ragebits/SE_Datalog/Datasheet Info/LTC3441 implementacion MODE SYNC.png

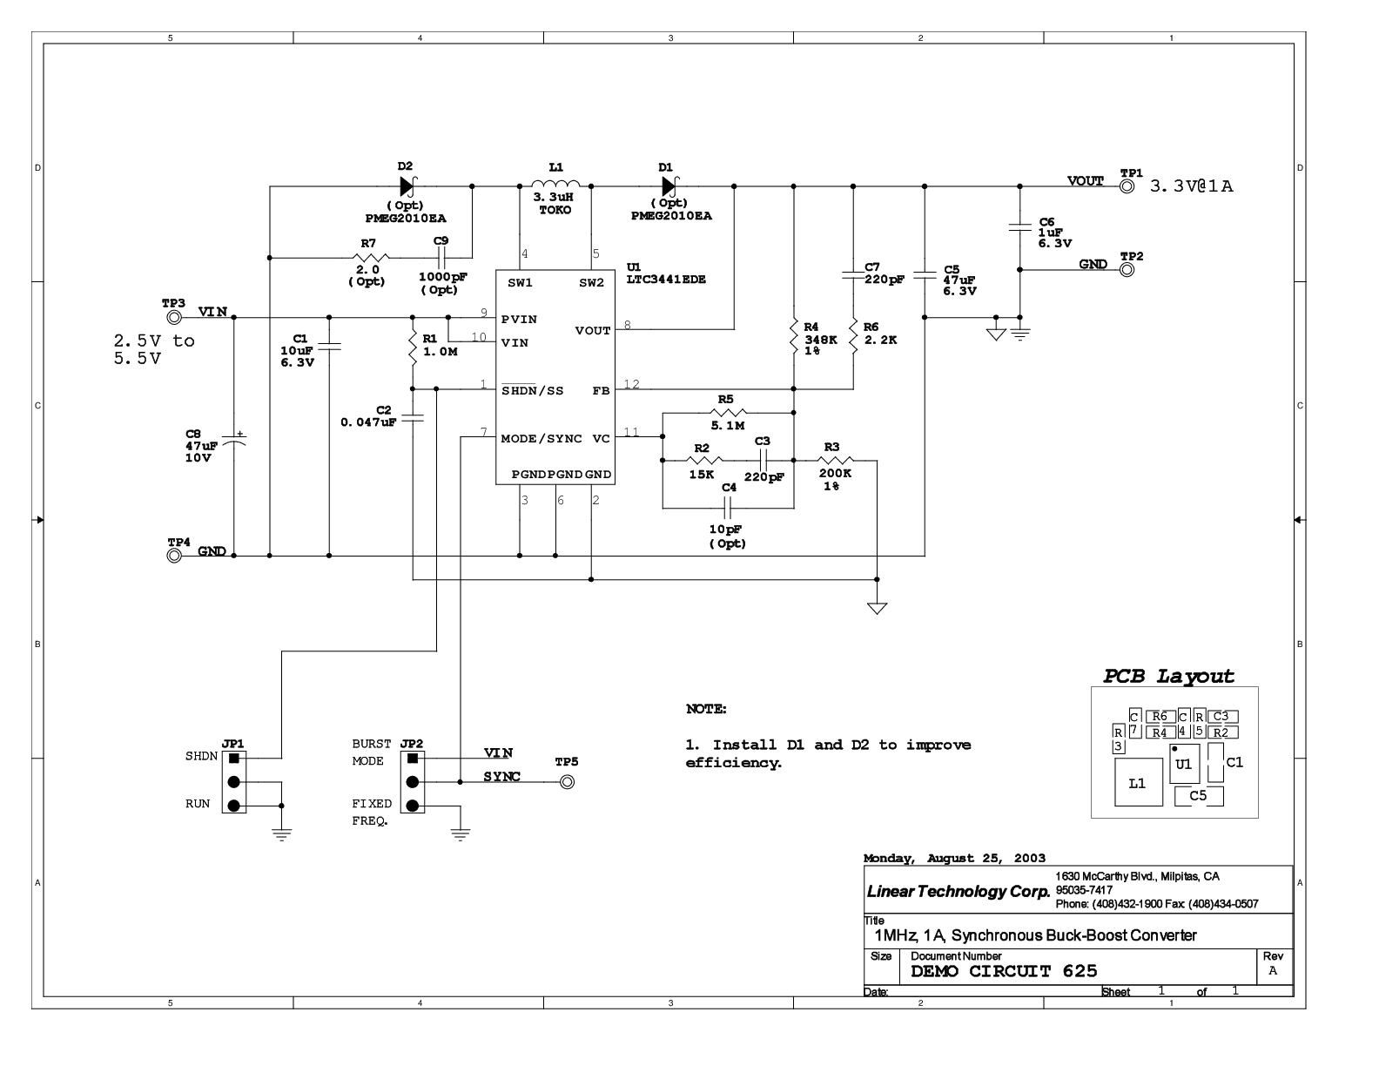
Datasheet Info/LTC3441 implementacion MODE SYNC.png
