ragebits/SE_Datalog/Layout componentes/1264EY-4R7M_P3/1264EY-4R7M_P3.step

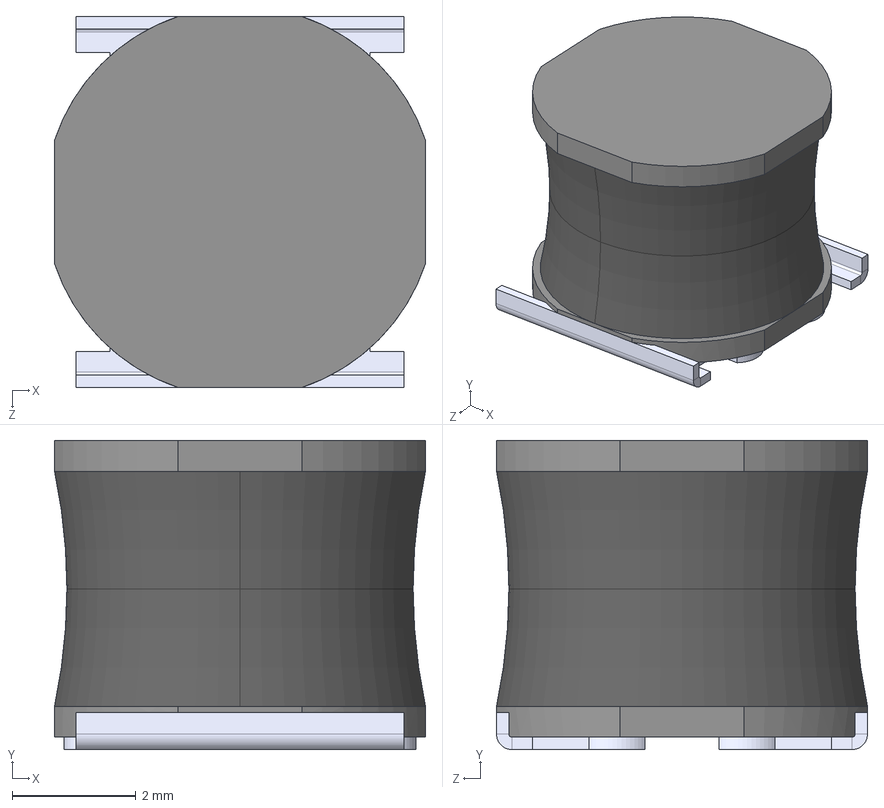
[picture p2: CAD file, 2021-05-06]
Layout componentes/1264EY-4R7M_P3/1264EY-4R7M_P3.step
6.00 x 5.00 x 6.00 mm
