ragebits/SE_Datalog/Layout componentes/B3U-1000P/B3U-1000P.step

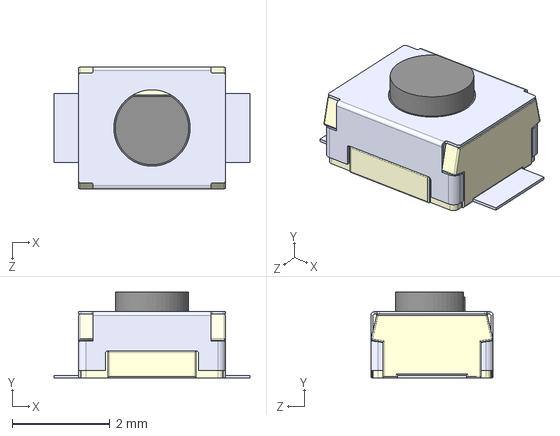
[picture p3: CAD file, 2021-04-28]
Layout componentes/B3U-1000P/B3U-1000P.step
4.00 x 1.75 x 2.50 mm
