ragebits/SE_Datalog/Layout componentes/BMP180-BY-68/bmp180-breakout-board-1.snapshot.2/BMP180 Breakout.step

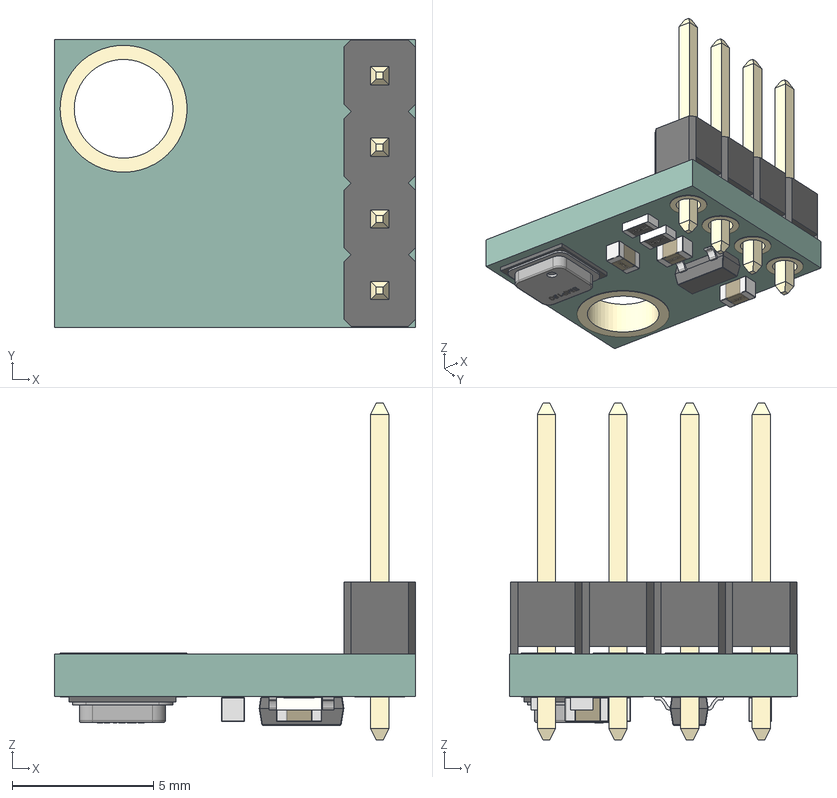
[picture p4: CAD file, 2021-07-25]
Layout componentes/BMP180-BY-68/bmp180-breakout-board-1.snapshot.2/BMP180 Breakout.step
12.8 x 10.2 x 11.9 mm
r-smd-0603 x 2
c-smd-0603 x 3
PinHeader
SOT23SMD v1
BMP180
