ragebits/SE_Datalog/Layout componentes/DM3AT-SF-PEJM5/DM3AT-SF-PEJM5.step

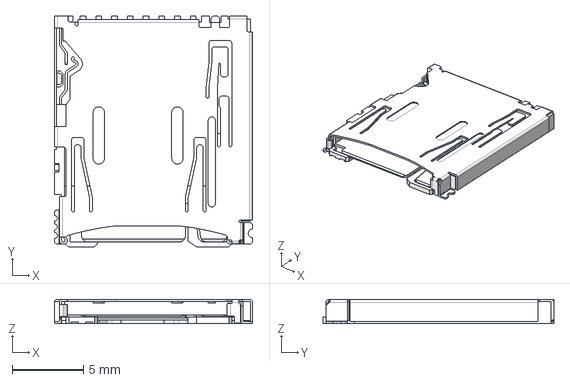
[picture p5: CAD file, 2021-05-06]
Layout componentes/DM3AT-SF-PEJM5/DM3AT-SF-PEJM5.step
13.8 x 16.2 x 1.68 mm
