ragebits/SE_Datalog/Layout componentes/ESP32-WROVER-I/ESP32-WROVER-I.step

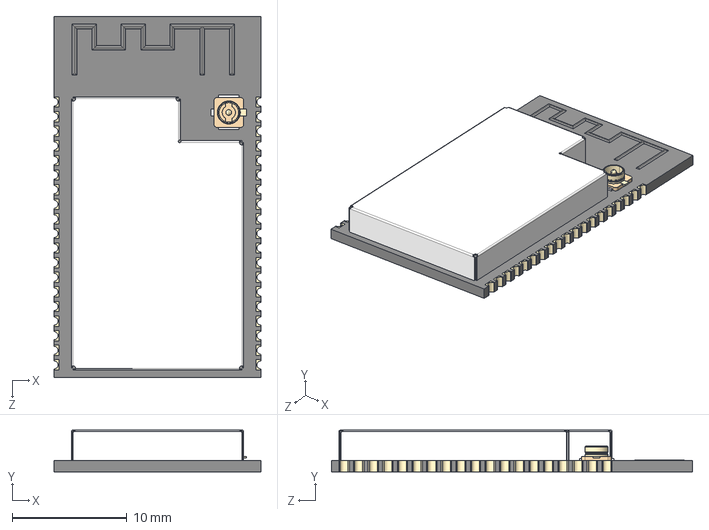
[picture p6: CAD file, 2021-04-28]
Layout componentes/ESP32-WROVER-I/ESP32-WROVER-I.step
18.0 x 3.65 x 31.4 mm
