ragebits/SE_Datalog/Layout componentes/ESP32-WROVER/ESP32-WROVER.step

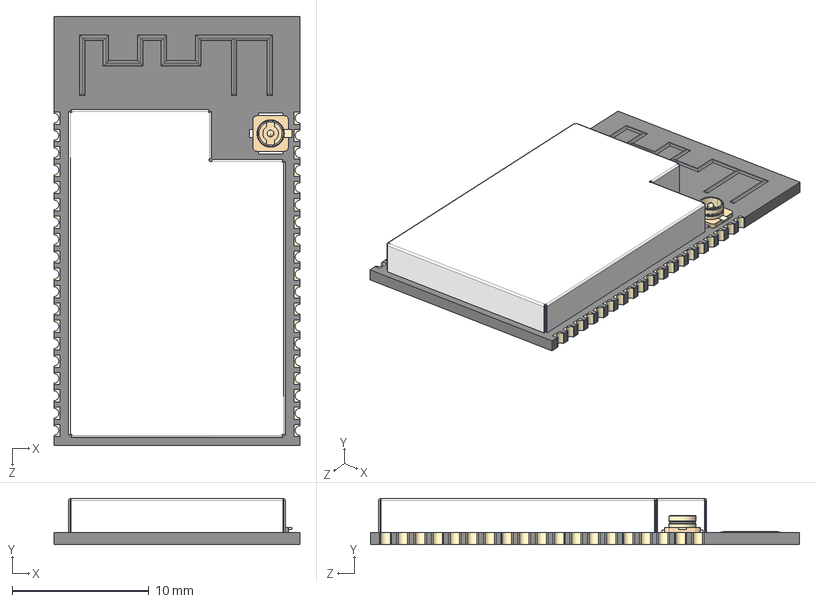
[picture p7: CAD file, 2021-04-28]
Layout componentes/ESP32-WROVER/ESP32-WROVER.step
18.0 x 3.40 x 31.4 mm
ESP-WROOM-02D board
UFL connector
