ragebits/SE_Datalog/Layout componentes/LIB_LTC3441EDE#PBF/LTC3441EDE#PBF/3D/LTC3441EDE#PBF.stp

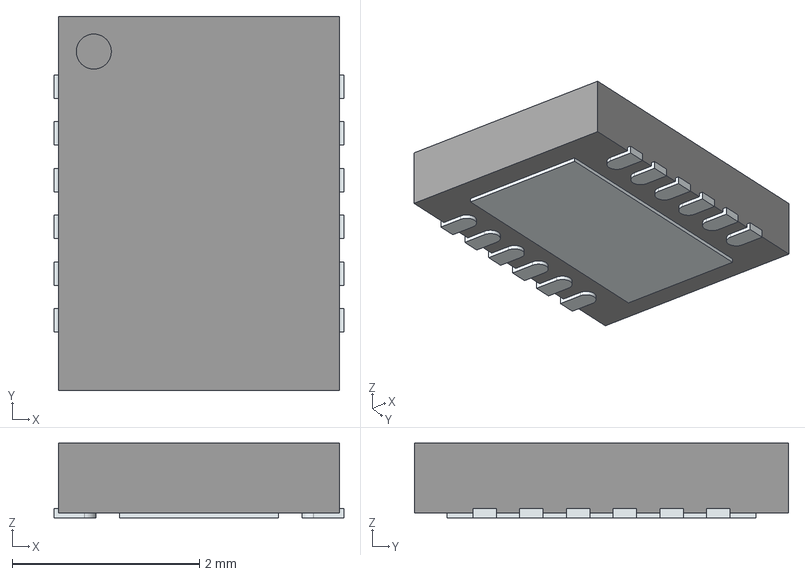
[picture p8: CAD file, 2021-07-20]
Layout componentes/LIB_LTC3441EDE#PBF/LTC3441EDE#PBF/3D/LTC3441EDE#PBF.stp
3.10 x 4.00 x 0.8 mm
ThermalPin
PinsArrayLR
