ragebits/SE_Datalog/Layout componentes/LTC3441EDEPBF/LTC3441EDEPBF.step

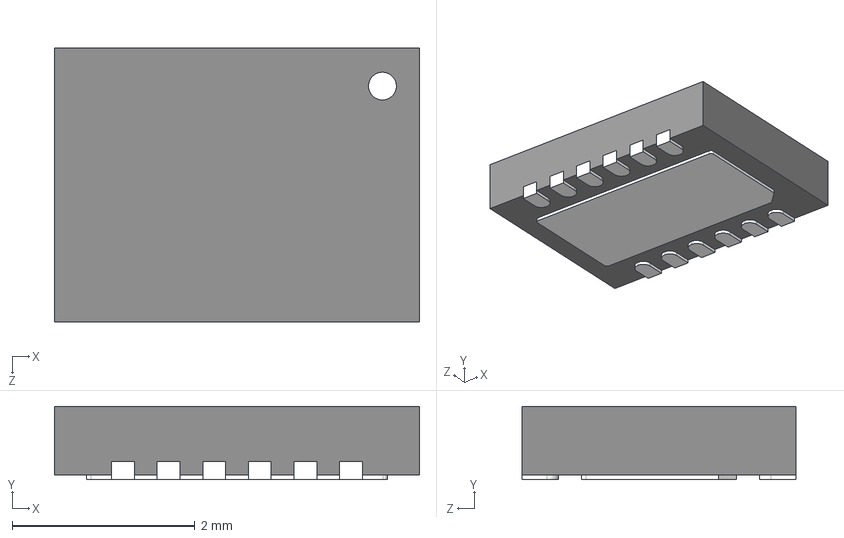
[picture p9: CAD file, 2021-05-06]
Layout componentes/LTC3441EDEPBF/LTC3441EDEPBF.step
4.00 x 0.8 x 3.00 mm
