ragebits/SE_Datalog/Layout componentes/RFM95W-915S2/RFM95W-868S2--3DModel-STEP-56544.STEP

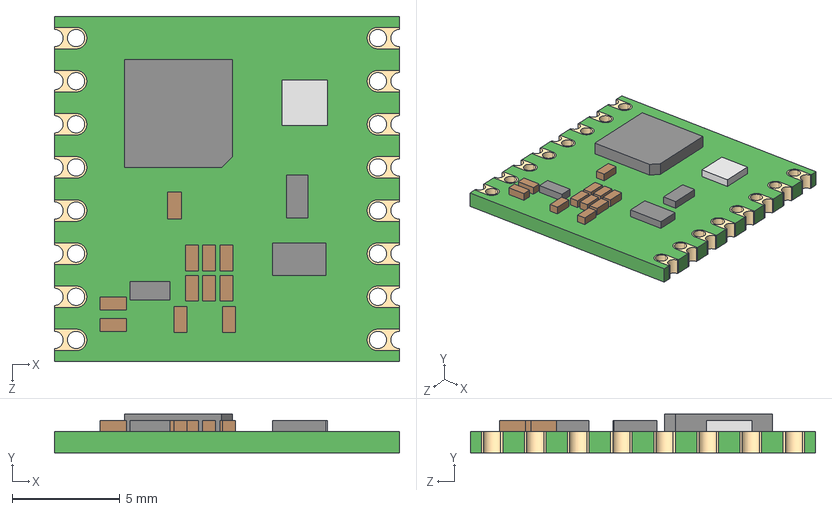
[picture p10: CAD file, 2021-07-25]
Layout componentes/RFM95W-915S2/RFM95W-868S2--3DModel-STEP-56544.STEP
16.0 x 1.80 x 16.0 mm
