ragebits/SE_Datalog/Layout componentes/TP4056/TP4056.step

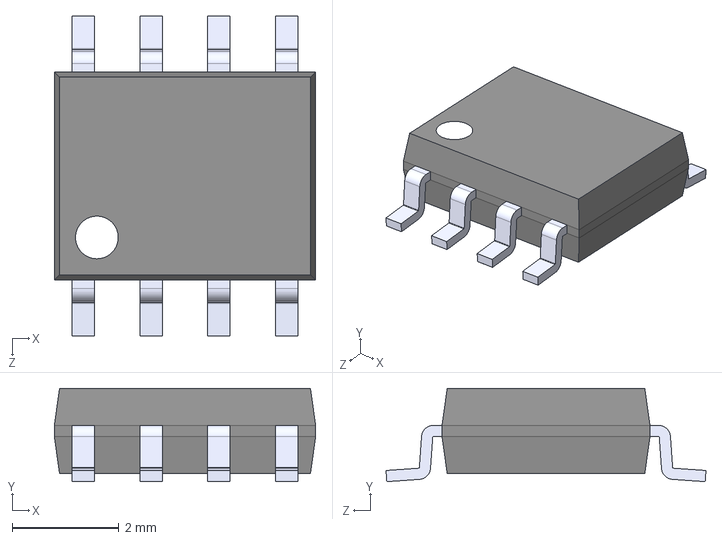
[picture p11: CAD file, 2021-05-06]
Layout componentes/TP4056/TP4056.step
4.90 x 1.75 x 6.00 mm
