ragebits/SE_Datalog/Layout componentes/U.FL-R-SMT_01_/U.FL-R-SMT_01_.step

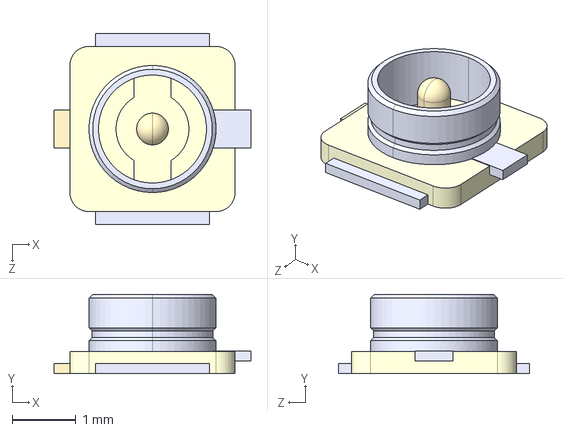
[picture p12: CAD file, 2021-04-26]
Layout componentes/U.FL-R-SMT_01_/U.FL-R-SMT_01_.step
3.10 x 1.25 x 3.00 mm
