ragebits/SE_Datalog/(list of files, cad)

Other CAD files:
Layout componentes/BMP180-BY-68/bmp180-breakout-board-1.snapshot.2/BMP180 Breakout.f3d
Layout componentes/LIB_LTC3441EDE#PBF/LTC3441EDE#PBF/3D/LTC3441EDE#PBF.stl
Layout componentes/LIB_LTC3441EDE#PBF/LTC3441EDE#PBF/Allegro/son50p300x400x80-13n-d.psm
Layout componentes/LIB_LTC3441EDE#PBF/LTC3441EDE#PBF/DEHDL/ltc3441ede#pbf/chips/chips.prt
