ragebits/SE_Datalog/SE_placa/SE_placa.kicad_pcb

## KiCad design SE_placa/SE_placa.kicad_pcb (2021-07-25)

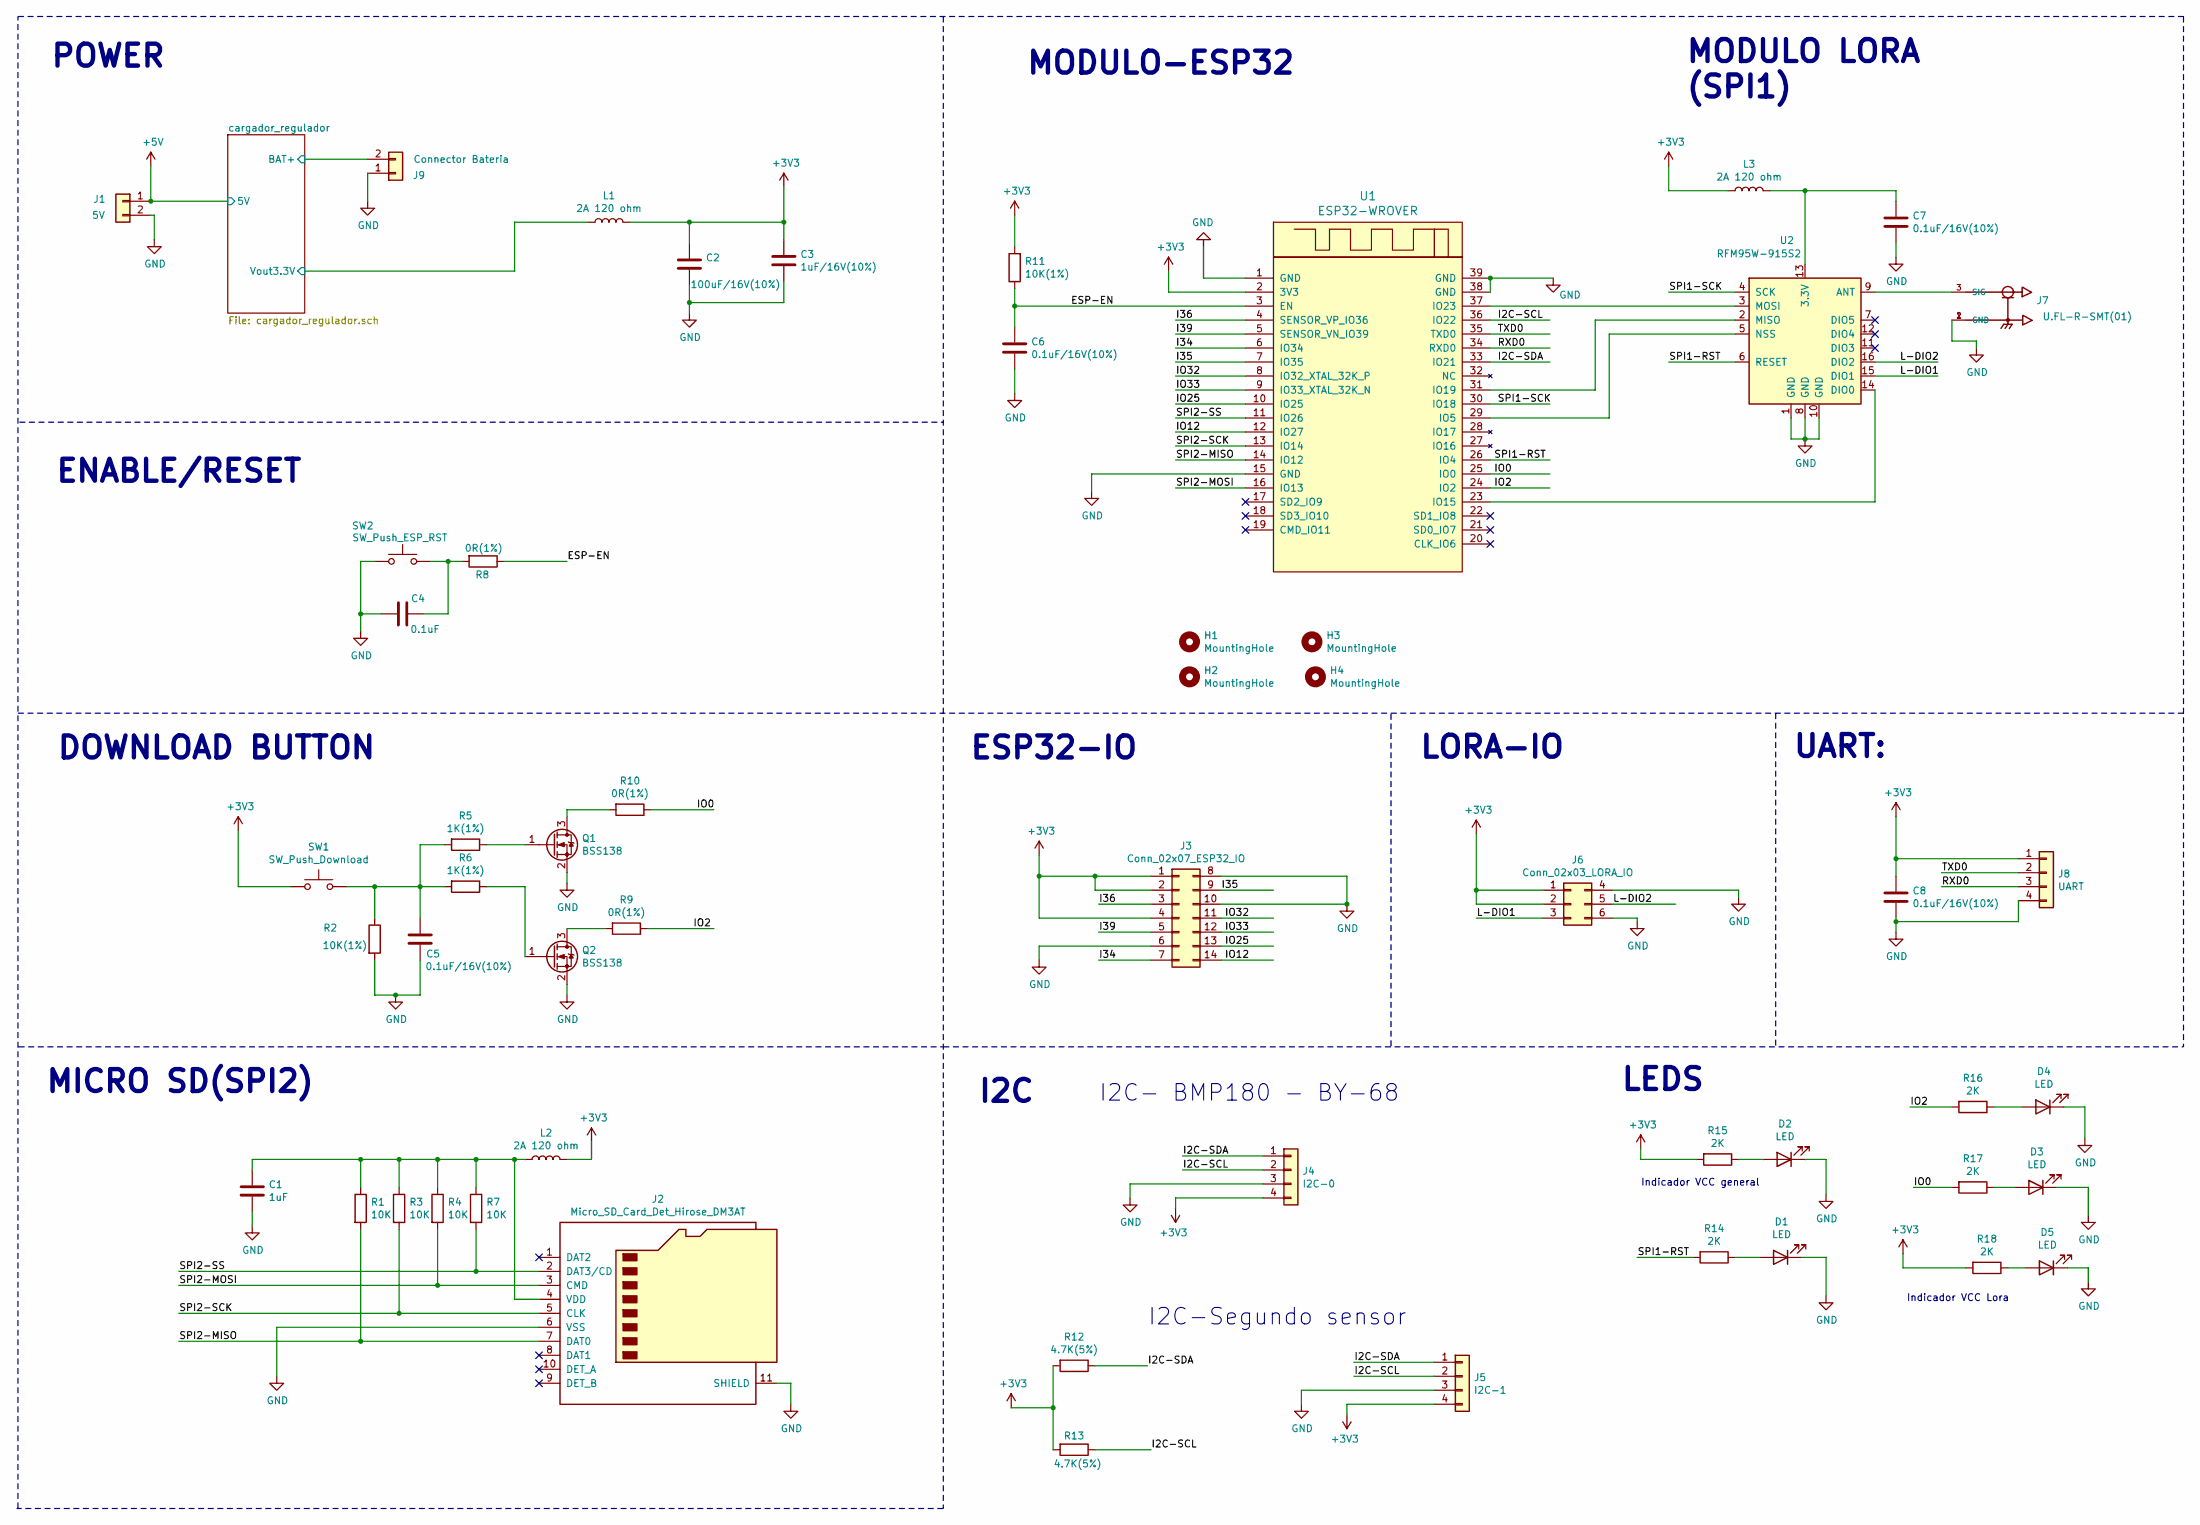
[picture p13: schematic SE_placa.sch, SE_1]

Parts:
C1: 1uF; C_0805_2012Metric_Pad1.18x1.45mm_HandSolder
C2: 100uF/16V(10%); C_0805_2012Metric_Pad1.18x1.45mm_HandSolder
C3: 1uF/16V(10%); C_0805_2012Metric_Pad1.18x1.45mm_HandSolder
C4: 0.1uF; C_0805_2012Metric_Pad1.18x1.45mm_HandSolder
C5, C6, C7, C8: 0.1uF/16V(10%); C_0805_2012Metric_Pad1.18x1.45mm_HandSolder
D1, D2, D3, D4, D5: LED; LED_0805_2012Metric_Pad1.15x1.40mm_HandSolder
H1, H2, H3, H4: MountingHole; MountingHole_2.5mm_Pad
J1: 5V; PinHeader_1x02_P2.54mm_Vertical
J2: Micro_SD_Card_Det_Hirose_DM3AT; microSD_HC_Hirose_DM3AT-SF-PEJM5
J3: Conn_02x07_ESP32_IO; PinSocket_2x07_P2.54mm_Vertical
J4: I2C-0; PinSocket_1x04_P2.54mm_Vertical
J5: I2C-1; PinSocket_1x04_P2.54mm_Vertical
J6: Conn_02x03_LORA_IO; PinSocket_2x03_P2.54mm_Vertical
J7: U.FL-R-SMT(01); HRS_U.FL-R-SMT(01)
J8: UART; PinSocket_1x04_P2.54mm_Vertical
J9: Connector Bateria; PinHeader_1x02_P2.54mm_Vertical
L1, L2, L3: 2A 120 ohm; L_0805_2012Metric_Pad1.15x1.40mm_HandSolder
Q1, Q2: BSS138; SOT-23
R1, R3, R4, R7: 10K; R_0805_2012Metric_Pad1.20x1.40mm_HandSolder
R2, R11: 10K(1%); R_0805_2012Metric_Pad1.20x1.40mm_HandSolder
R5, R6: 1K(1%); R_0805_2012Metric_Pad1.20x1.40mm_HandSolder
R8, R9, R10: 0R(1%); R_0805_2012Metric_Pad1.20x1.40mm_HandSolder
R12, R13: 4.7K(5%); R_0805_2012Metric_Pad1.20x1.40mm_HandSolder
R14, R15, R16, R17, R18: 2K; R_0805_2012Metric_Pad1.20x1.40mm_HandSolder
SW1: SW_Push_Download; SW_SPST_CK_RS282G05A3
SW2: SW_Push_ESP_RST; SW_SPST_CK_RS282G05A3
U1: ESP32-WROVER; XCVR_ESP32-WROVER-I
U2: RFM95W-915S2; HOPERF_RFM9XW_SMD

Connections:
+3V3: C2.1, C3.1, C8.1, J3.1, J3.2, J3.4, J4.4, J5.4, J6.1, J6.2, J8.1, L1.2, L2.2, L3.1, R11.2, R12.2, R13.2, R15.2, R18.2, SW1.1, U1.2 (3V3)
+5V: J1.1; also elsewhere on the board
/ESP-EN: C6.2, R8.1, R11.1, U1.3 (EN)
/I2C-SCL: J4.2, J5.2, R13.1, U1.36 (IO22)
/I2C-SDA: J4.1, J5.1, R12.1, U1.33 (IO21)
/I34: J3.7, U1.6 (IO34)
/I35: J3.9, U1.7 (IO35)
/I36: J3.3, U1.4 (SENSOR_VP_IO36)
/I39: J3.5, U1.5 (SENSOR_VN_IO39)
/IO0: R10.1, R17.2, U1.25 (IO0)
/IO2: R9.1, R16.2, U1.24 (IO2)
/IO12: J3.14, U1.12 (IO27)
/IO25: J3.13, U1.10 (IO25)
/IO32: J3.11, U1.8 (IO32_XTAL_32K_P)
/IO33: J3.12, U1.9 (IO33_XTAL_32K_N)
/L-DIO1: J6.3, U2.15 (DIO1)
/L-DIO2: J6.5, U2.16 (DIO2)
/RXD0: J8.3, U1.34 (RXD0)
/SPI1-RST: R14.2, U1.26 (IO4), U2.6 (RESET)
/SPI1-SCK: U1.30 (IO18), U2.4 (SCK)
/SPI2-MISO: J2.7 (DAT0), R1.2, U1.14 (IO12)
/SPI2-MOSI: J2.3 (CMD), R4.2, U1.16 (IO13)
/SPI2-SCK: J2.5 (CLK), R3.2, U1.13 (IO14)
/SPI2-SS: J2.2 (DAT3/CD), R7.2, U1.11 (IO26)
/TXD0: J8.2, U1.35 (TXD0)
/cargador_regulador/BAT+: J9.2; also elsewhere on the board
/cargador_regulador/Vout3.3V: L1.1; also elsewhere on the board
GND: C1.2, C2.2, C3.2, C4.2, C5.2, C6.1, C7.2, C8.2, D1.1 (K), D2.1 (K), D3.1 (K), D4.1 (K), D5.1 (K), J1.2, J2.6 (VSS), J2.11 (SHIELD), J3.6, J3.8, J3.10, J4.3, J5.3, J6.4, J6.6, J7.1 (GND), J7.2 (GND), J8.4, J9.1, Q1.2 (S), Q2.2 (S), R2.2, SW2.1, U1.1 (GND), U1.15 (GND), U1.38 (GND), U1.39 (GND), U2.1 (GND), U2.8 (GND), U2.10 (GND); also elsewhere on the board
unnamed: C1.1, J2.4 (VDD), L2.1, R1.1, R3.1, R4.1, R7.1
unnamed: C4.1, R8.2, SW2.2
unnamed: C5.1, R2.1, R5.2, R6.2, SW1.2
unnamed: C7.1, L3.2, U2.13 (3.3V)
unnamed: D1.2 (A), R14.1
unnamed: D2.2 (A), R15.1
unnamed: D3.2 (A), R17.1
unnamed: D4.2 (A), R16.1
unnamed: D5.2 (A), R18.1
unnamed: J7.3 (SIG), U2.9 (ANT)
unnamed: Q1.1 (G), R5.1
unnamed: Q1.3 (D), R10.2
unnamed: Q2.1 (G), R6.1
unnamed: Q2.3 (D), R9.2
unnamed: U1.23 (IO15), U2.14 (DIO0)
unnamed: U1.29 (IO5), U2.5 (NSS)
unnamed: U1.31 (IO19), U2.2 (MISO)
unnamed: U1.37 (IO23), U2.3 (MOSI)

Notes on the sheet:
POWER
I2C- BMP180 - BY-68
MICRO SD(SPI2)
MODULO-ESP32
MODULO LORA (SPI1)
DOWNLOAD BUTTON
ENABLE/RESET
LEDS
LORA-IO
I2C
I2C-Segundo sensor
ESP32-IO
UART:
Indicador VCC general
Indicador VCC Lora

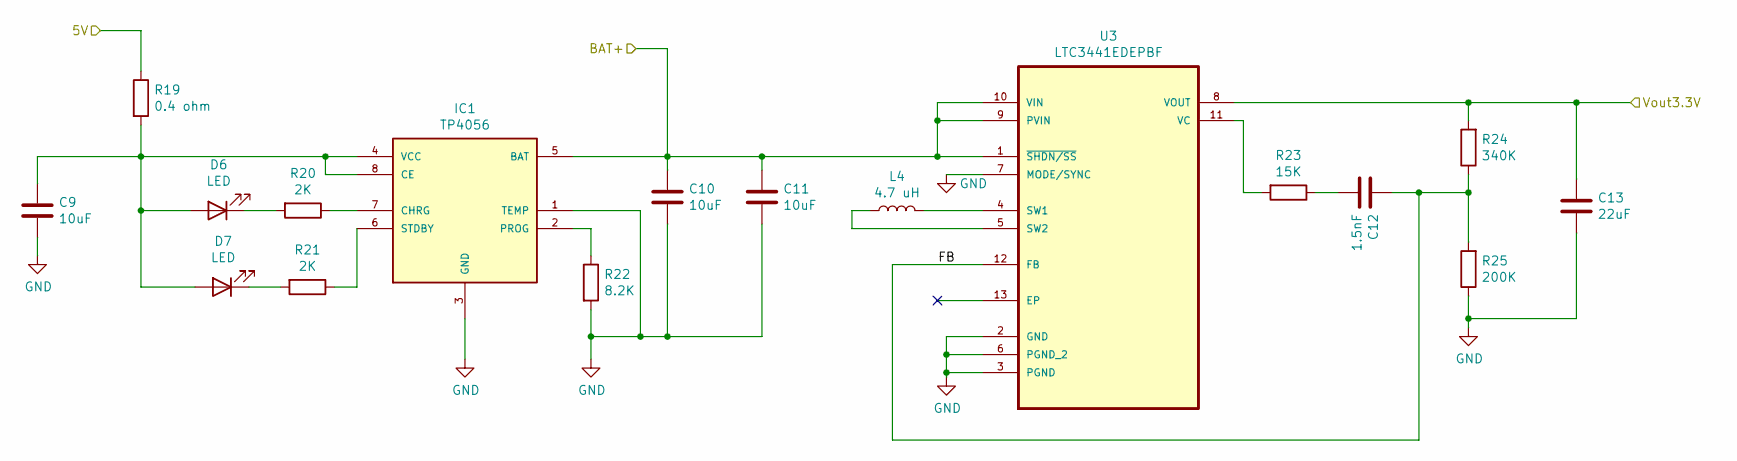
[picture p14: schematic cargador_regulador.sch, Cargador Regulador bateria litio]

Parts:
C9, C10, C11: 10uF; C_0805_2012Metric_Pad1.18x1.45mm_HandSolder
C12: 1.5nF; C_0805_2012Metric_Pad1.18x1.45mm_HandSolder
C13: 22uF; C_0805_2012Metric_Pad1.18x1.45mm_HandSolder
D6, D7: LED; LED_0805_2012Metric_Pad1.15x1.40mm_HandSolder
IC1: TP4056; SOP-8
L4: 4.7 uH; IND_1264EY-4R7M=P3
R19: 0.4 ohm; R_0805_2012Metric_Pad1.20x1.40mm_HandSolder
R20, R21: 2K; R_0805_2012Metric_Pad1.20x1.40mm_HandSolder
R22: 8.2K; R_0805_2012Metric_Pad1.20x1.40mm_HandSolder
R23: 15K; R_0805_2012Metric_Pad1.20x1.40mm_HandSolder
R24: 340K; R_0805_2012Metric_Pad1.20x1.40mm_HandSolder
R25: 200K; R_0805_2012Metric_Pad1.20x1.40mm_HandSolder
U3: LTC3441EDEPBF; SON50P300X400X80-13N-D; MPN LTC3441EDE#PBF

Connections:
+5V: R19.1; also elsewhere on the board
/cargador_regulador/BAT+: C10.1, C11.1, IC1.5 (BAT), U3.1 (~SHDN/SS), U3.9 (PVIN), U3.10 (VIN); also elsewhere on the board
/cargador_regulador/FB: C12.1, R24.1, R25.2, U3.12 (FB)
/cargador_regulador/Vout3.3V: C13.1, R24.2, U3.8 (VOUT); also elsewhere on the board
GND: C9.2, C10.2, C11.2, C13.2, IC1.1 (TEMP), IC1.3 (GND), R22.2, R25.1, U3.2 (GND), U3.3 (PGND), U3.6 (PGND_2), U3.7 (MODE/SYNC); also elsewhere on the board
unnamed: C9.1, D6.2 (A), D7.2 (A), IC1.4 (VCC), IC1.8 (CE), R19.2
unnamed: C12.2, R23.1
unnamed: D6.1 (K), R20.2
unnamed: D7.1 (K), R21.2
unnamed: IC1.2 (PROG), R22.1
unnamed: IC1.6 (STDBY), R21.1
unnamed: IC1.7 (CHRG), R20.1
unnamed: L4.1, U3.5 (SW2)
unnamed: L4.2, U3.4 (SW1)
unnamed: R23.2, U3.11 (VC)

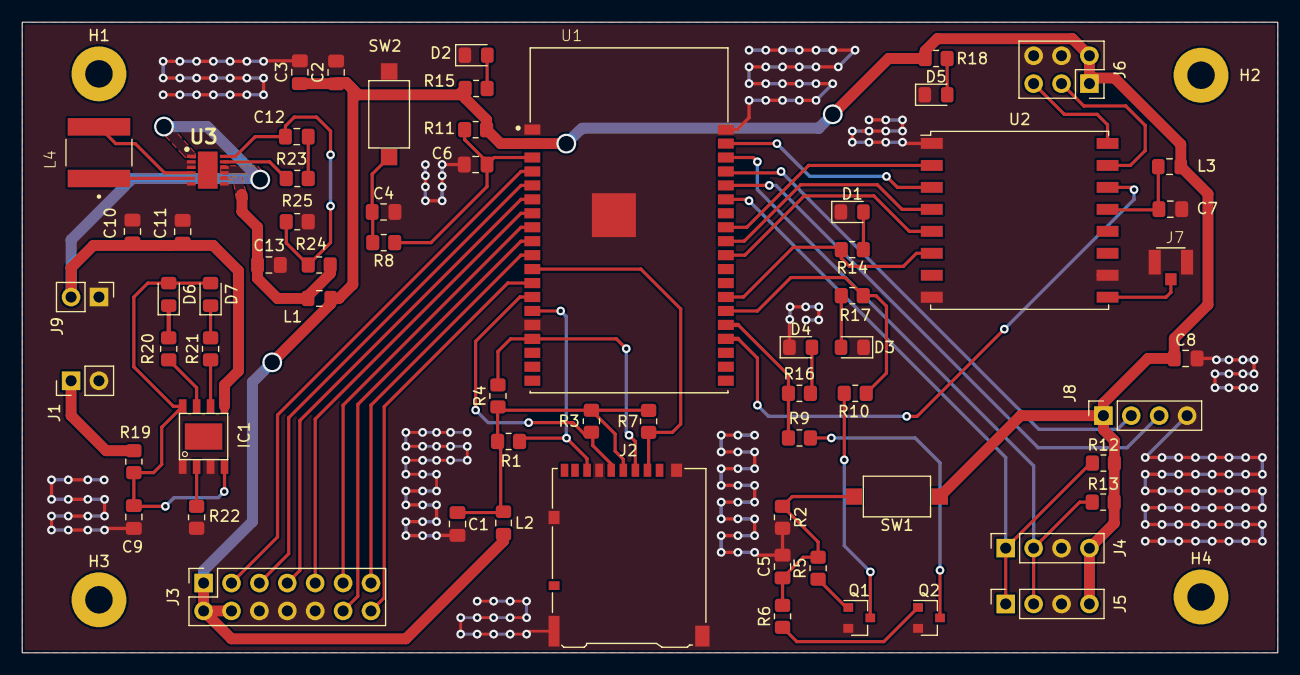
[picture p15: board SE_placa.kicad_pcb from above]

Board: 2 copper layers, 114.3 x 57.4 mm, 70 parts (0 on the bottom side), 57 nets.
