ragebits/SE_Datalog/(commit log)

2021-04-13 Creacion de archivos de poyecto
    Creacion de archivos de poyecto
    [SE_placa.kicad_pcb, SE_placa.sch]
2021-04-15 Agregado de info
    Se agrego información de referencia del diseño y del desarrollo del proyecto . Se incluyo el diagrama de conexionado en kicad
    [SE_placa.sch]
2021-04-15 Carga Listado de distribucion de pin utilizados
    carga Listado de distribucion de pin utilizados y carga de comparativo de seleccion de componentes
    [Comparativos.xlsx, ESP32 Pins.xlsx]
2021-04-26 Organizar
    Se organizo la distribución de los espacios, se separo la fuente del ESP32 y la fuente de alimentación
    [SE_placa.sch]
2021-04-26 Cambio modelo de Hoja A3
    organizo hoja de esquematico a formato A3. Incluyo libreria de conector UFL. Organizo Alimentacion, incluyo bobinas para I/O salidas. Incluyo switches de EN y de Programacion IO0, IO2, incluyo algunos condensadores y leds
    [ESP32 Pins.xlsx, SE_placa.sch, U.FL-R-SMT_01_.step]
2021-04-27 Finalizacion del layout
    Se ordeno nuevamente el layout, se completaron conexion de los modulos, se incluyo conexion de I/O del modulo lora al ESP, se incluyeron los I/O de lora. se amplio la cantidad de pines del conector de IO del ESP32. Se incluyeron valores de bobinas de ferrita para los lazos de alimentacion. Se modifico el excel con Pin out y se incluyo una hoja con pines de lora.
    [ESP32 Pins.xlsx, SE_placa.sch]
2021-04-28 Se asociaron footprints
    Se pusieron los footprints y se pudo asociar las librerias de los elementos, escogiendolos comercialmente y midiendo con los que ya tengo en mi poder.
    [B3U-1000P.step, ESP32-Footprints.kicad_pcb, ESP32-Footprints.sch, ESP32-WROVER-I.step, ESP32-WROVER.step, SE_placa.sch]
2021-04-29 Actualizacion de huellas y correccion de errores de layout
    Corrigieron los errores de layout, se incluyeron power conector y se señalaron los pines que no se concetan, se actualizaron huellas a elementos comerciales, se cambio la huella del Micro SD y del conector de antena del modulo lora. Se inicio con el diseño del PCB haciendo una primera distribucion de los elementos
    [SE_placa.kicad_pcb, SE_placa.sch]
2021-04-29 Actualizacion de PCB solo rutas
    Eliminado un led repetido, el led 5. Primer intento crudo de desarrollar la PCB sin estandares, tamaños de caminos u otras consideraciones tecnicas, solo ruteo para ir entendiendo y aprendiendo cual es la mejor ubicacion de los elementos, tambien saber si puedo llegar en algun momento a la meta de 52 mm X 40 mm.
    [SE_placa.kicad_pcb, SE_placa.sch]
2021-04-29 reinicio de ruteo
    [SE_placa.kicad_pcb]
2021-05-04 Corregida Grid, reinciado el PCB
    Crroegido grid a 25 mil, reconectado el layout, se cambiaron ubicación de algunos elementos dentro de la sabana . se retiraron las resistencias de 0 ohm no necesarias en la I/O, se cambio bonina por resistencia de p ohm en diagrama reset se agregó resistencias pull up a I2C, , se reitaron resistencias pull up no necesarias en la conexion de la Micro SD. Se organizaron las fuentes de todo el circuito, 3.3V Alimentación 3V3 punto de conexion ESP y 3.3VP punto de conexion Lora.
    [Comparativos.xlsx, SE_placa.kicad_pcb, SE_placa.sch]
2021-05-06 Circuito Alimentacion
    Agregado Ic para carga de bateria de litio , agregado IC tipo Buck-bost para asegurar alimentacion 3.3 V 1 A para alimentacion de circuitos. Este circuito esta incluido en una nueva hoja.
    [Comparativos.xlsx, ESP32 Pins.xlsx, LTC3441EDEPBF.step, SE_placa.sch, TP4056.step, cargador_regulador.sch]
2021-05-06 Actualizacion de fechas
    [SE_placa.sch, cargador_regulador.sch]
2021-05-06 Actualizacion PCB
    Organizo archivos, agrego nuevos elementos a footprint, actualizo net list y actualizo PCB, agrego modelos 3D disponibles. Listo para iniciar ruteo
    [1264EY-4R7M_P3.step, B3U-1000P.step, DM3AT-SF-PEJM5.step, ESP32-Footprints.kicad_pcb, ESP32-Footprints.sch, ESP32-WROVER-I.step, ESP32-WROVER.step, SE_placa.kicad_pcb]
2021-06-28 Inclusion informacion ref SINK SOURCE
    [SE_placa.kicad_pcb]
2021-07-01 Organizar integrado rev A
    [SE_placa.kicad_pcb, SE_placa.sch]
2021-07-06 Ubicaciones de librerias de absolutas a relativas
    [SE_placa.sch, cargador_regulador.sch]
2021-07-13 ruteo 1
    1. Agregados mounting holes 2.5 mm
    2. Reordeno elementos para hacer mas facil el ruteo.
    3. Ordeno los leds para indicar mejor el estado de lora y alimentacion general
    4. Ordeno lesd y conectores de bateria y alimentacion por panel
    giro conectores de I/o de lora
    en general se dejaron por grupos los elementos de acuerdo al tipo de funcion dentro de la placa
    [SE_placa.kicad_pcb, SE_placa.sch]
2021-07-13 continuacion de ruteo
    Solo queda por rutear tierras.
    agrego regla de ruteo para el U3 elemento mas pequeño regulador LTC3441, aun siguen generando error la base del elemento.
    [SE_placa.kicad_pcb]
2021-07-13 ruteo de tierras
    [SE_placa.kicad_pcb]
2021-07-13 actualizacion tierra
    [SE_placa.kicad_pcb]
2021-07-15 Ruteo 2
    Aumento el ancho de las pistas de señales a 0.4 m
    aumento las pistas de alimentacion a 1 mm
    modifico ubicacion de elementos para mejorar ruteo evitando pasar por debajo de elementos
    [SE_placa.kicad_pcb, SE_placa.sch]
2021-07-20 Ruteo 3
    1. Cambio orden de los pines de I/O para hacer mas facil el ruteo de los conectores, modifico ubicacion de I/Os del Lora
    2. Cambio huella del LTC 3441 al parecer la que tenia creaba conflictos con las rutas y sus anchos
    3. cambio el esquema de Net classes a default, arreglando el tamaño de las rutas y de las vias .
    4. Modifico la ruta a 0.3 mm , agrego esto a pre definidas
    5. agrego ruta de 1 mm y vias de 1.8 mm para alimentaciones
    6. cambio ubicaciones de conectorres de bateria y de panel solar
    7. cambio ubicacion del TP4056 y modifico la ubicacion de los componentes cercanos.
    8. Falta agregar plano de tierra en las dos caras y modificar salida de potencia de la entrada y la salida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
    [EDI2CAP.CFG, LTC3441EDE#PBF.stl, LTC3441EDE#PBF.stp, SE_placa.kicad_pcb, SE_placa.sch, cargador_regulador.sch, chips.prt, son50p300x400x80-13n-d.psm]
2021-07-20 Ruteo y vias
    Se pusieron zonas para agrandar los caminos falta poner las capas de tierra
    [SE_placa.kicad_pcb]
2021-07-21 Update SE_placa.kicad_pcb
    Organizando los nombres de los componentes para que se puedan leer
    [SE_placa.kicad_pcb]
2021-07-21 Gerber files
    Generacion de archivos gerber
    [SE_placa-B_Cu.gbr, SE_placa-B_Mask.gbr, SE_placa-B_Paste.gbr, SE_placa-B_SilkS.gbr, SE_placa-Edge_Cuts.gbr, SE_placa-F_Cu.gbr, SE_placa-F_Mask.gbr, SE_placa-F_Paste.gbr]
2021-07-25 Actualizacion de Modelos 3D
    Actualizo los modelos 3D de todos los elementos, los cargo en el directorio de huellas y modelos del proyecto
    [BMP180 Breakout.f3d, BMP180 Breakout.step, RFM95W-868S2--3DModel-STEP-56544.STEP, SE_placa.kicad_pcb]
